FlyyingPiggy2020/HT3505-J9-2E/FreeCAD/HT3505-J9-2E.png

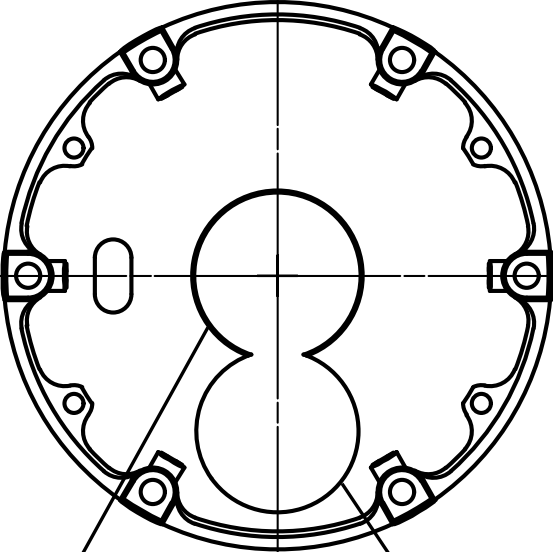
FreeCAD/HT3505-J9-2E.png
