FlyyingPiggy2020/HT3505-J9-2E/KiCad/HT3505-J9-2E-MCU-V1.01/review/latest-driver.png

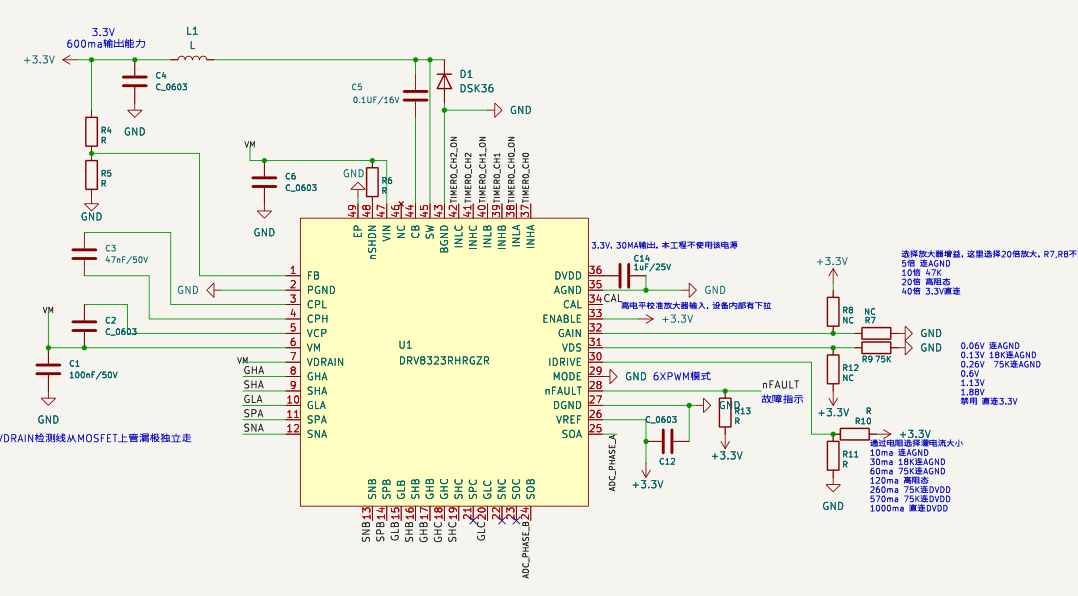
KiCad/HT3505-J9-2E-MCU-V1.01/review/latest-driver.png
