FlyyingPiggy2020/HT3505-J9-2E/KiCad/HT3505-J9-2E-MCU-V1.01/review/mt6701-i2c.png

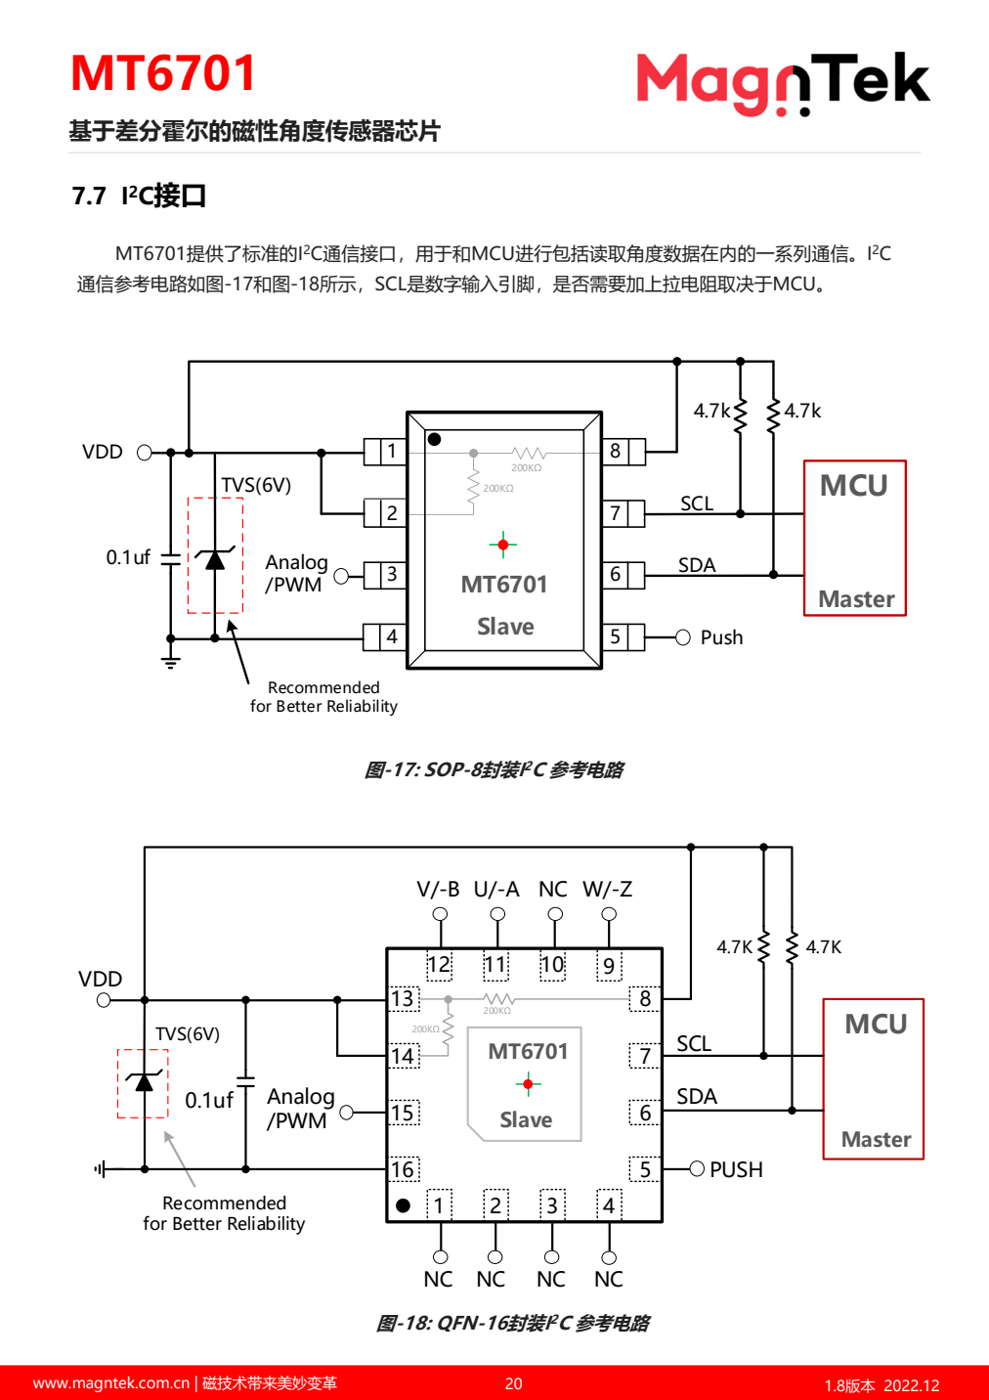
KiCad/HT3505-J9-2E-MCU-V1.01/review/mt6701-i2c.png
