FlyyingPiggy2020/HT3505-J9-2E/FreeCAD/Housing-BodySketch.dxf

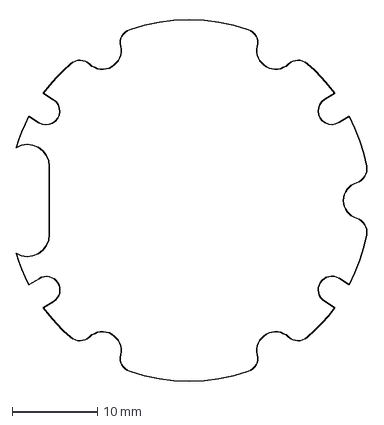
[picture p9: CAD file, 2026-09-28]
FreeCAD/Housing-BodySketch.dxf
41.4 x 43.3 mm
