FlyyingPiggy2020/HT3505-J9-2E/KiCad/HT3505-J9-2E.stl

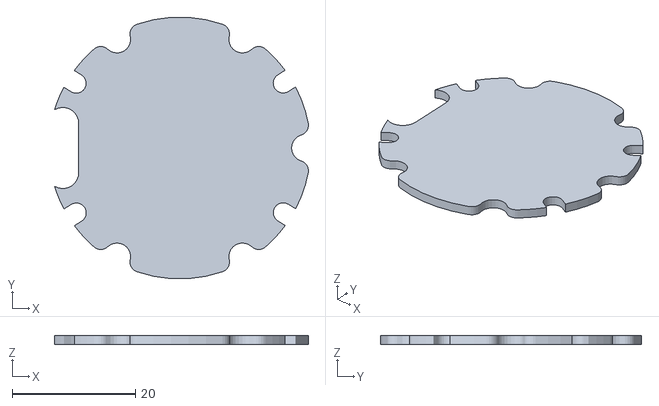
[picture p10: CAD file, 2026-09-28]
KiCad/HT3505-J9-2E.stl
41.2 x 42.4 x 1.51
