FlyyingPiggy2020/HT3505-J9-2E/(list of files, cad)

Other CAD files:
FreeCAD/Housing.FCStd
