FlyyingPiggy2020/HT3505-J9-2E/KiCad/HT3505-J9-2E-MCU-V1.01/review/sep26-schematic.pdf

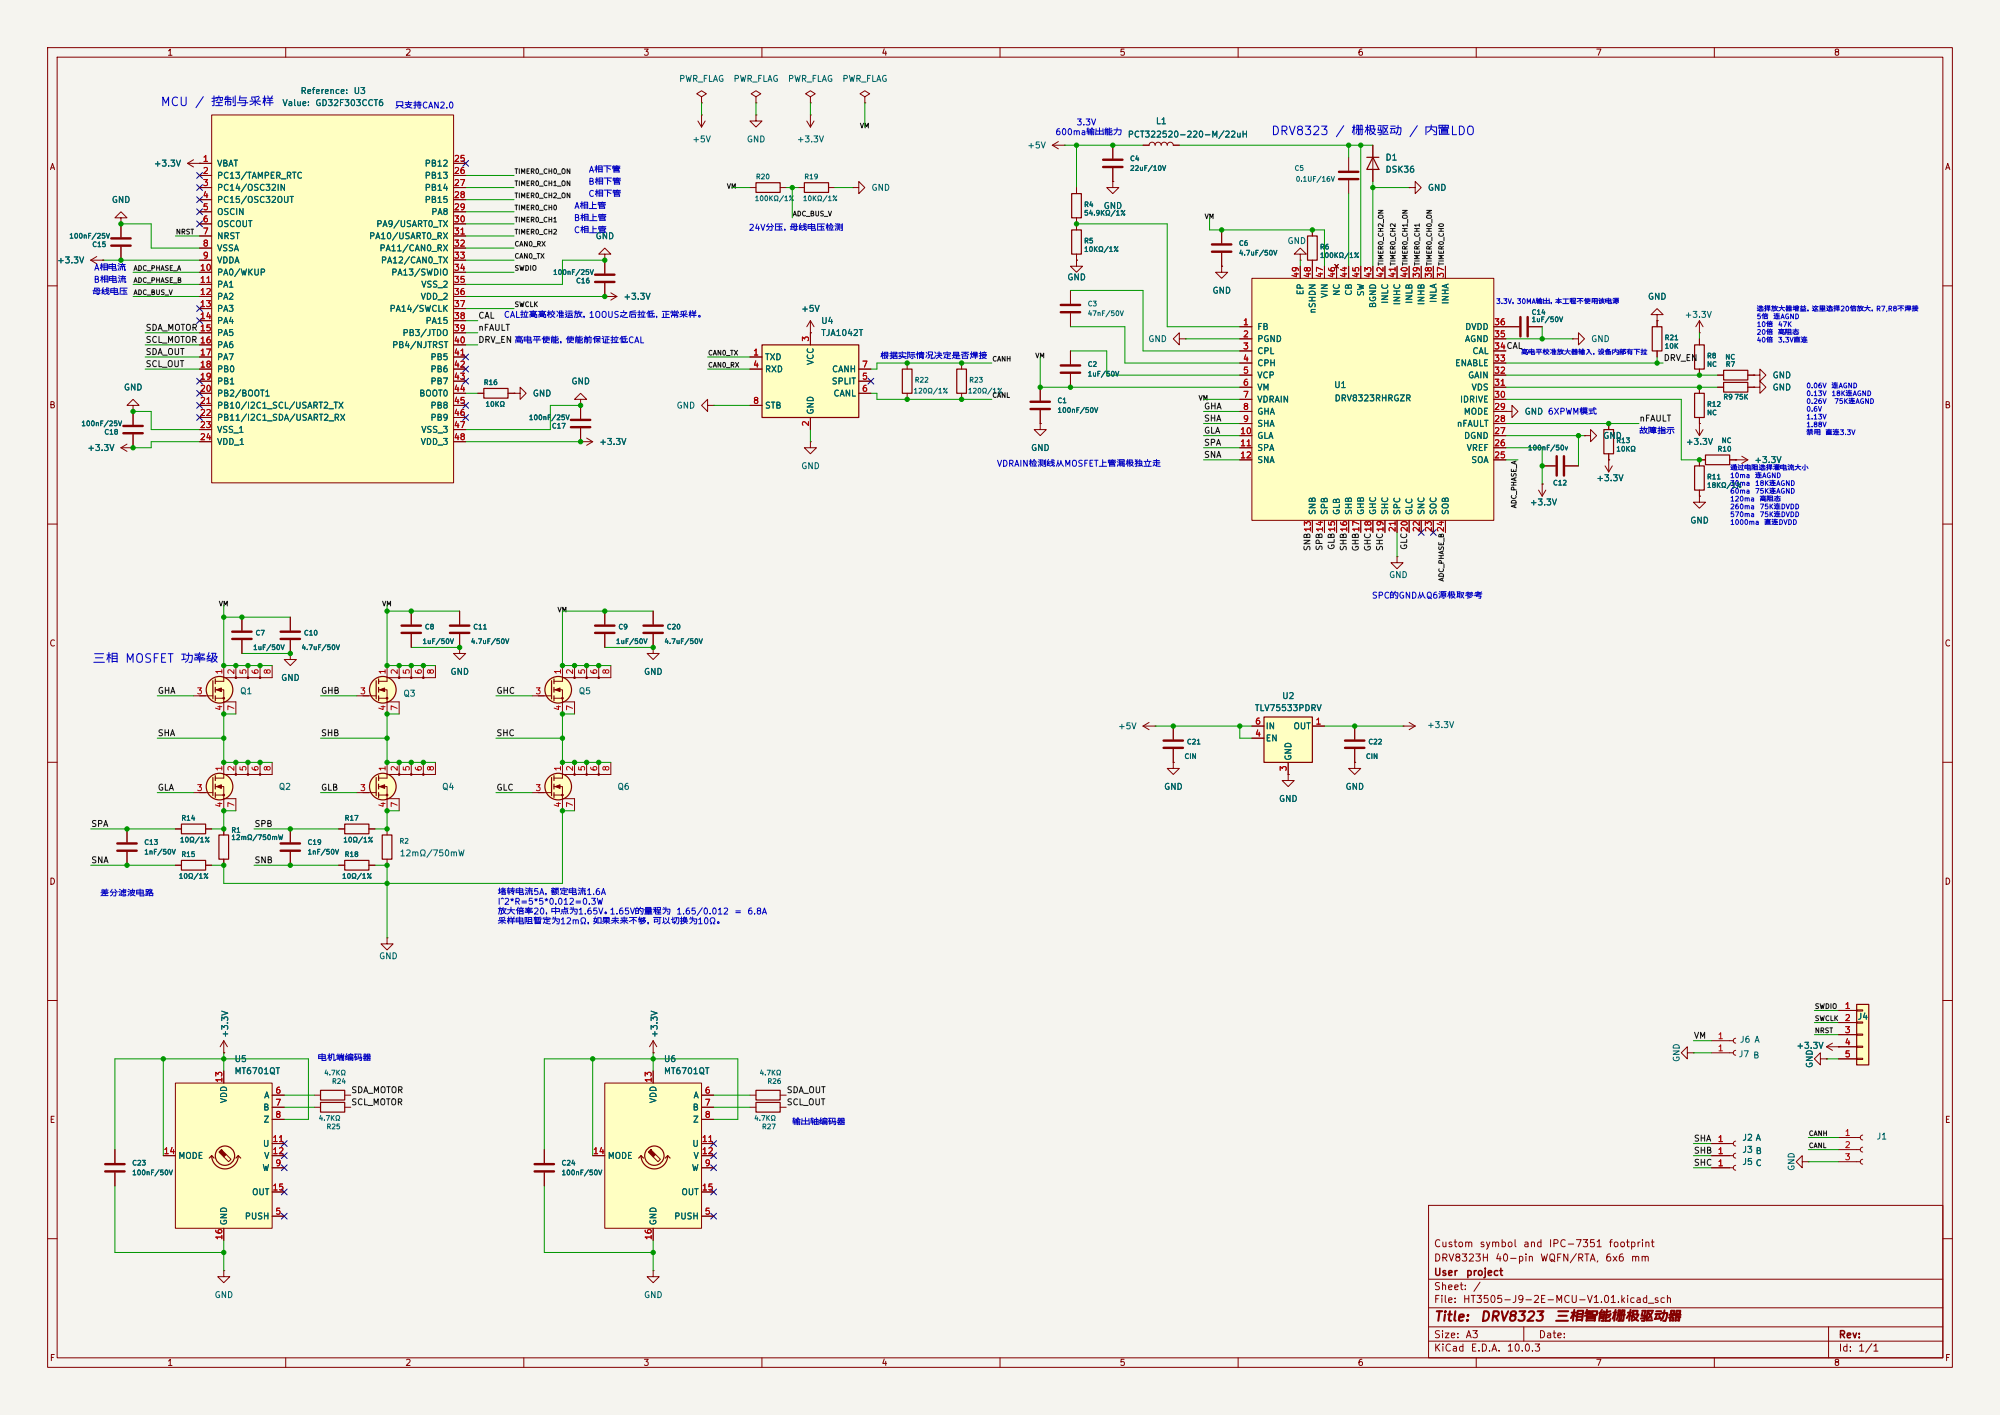
[picture p11: page 1]

0.6V 1.13V 1.88V 禁用 直连3.3V A相电流
B相电流
母线电压
3.3V，30MA输出，本工程不使用该电源 三相 MOSFET 功率级

Custom symbol and IPC-7351 footprint
DRV8323H 40-pin WQFN/RTA, 6x6 mm
User project
Sheet: /
File: HT3505-J9-2E-MCU-V1.01.kicad_sch
Title: DRV8323 三相智能栅极驱动器

Size: A3 | Rev: | F Date:
KiCad E.D.A. 10.0.3 | Id: 1/1
