FlyyingPiggy2020/HT3505-J9-2E/FreeCAD/HT3505-J9-2E电机双编-无驱动盖-安装图-20250916.pdf

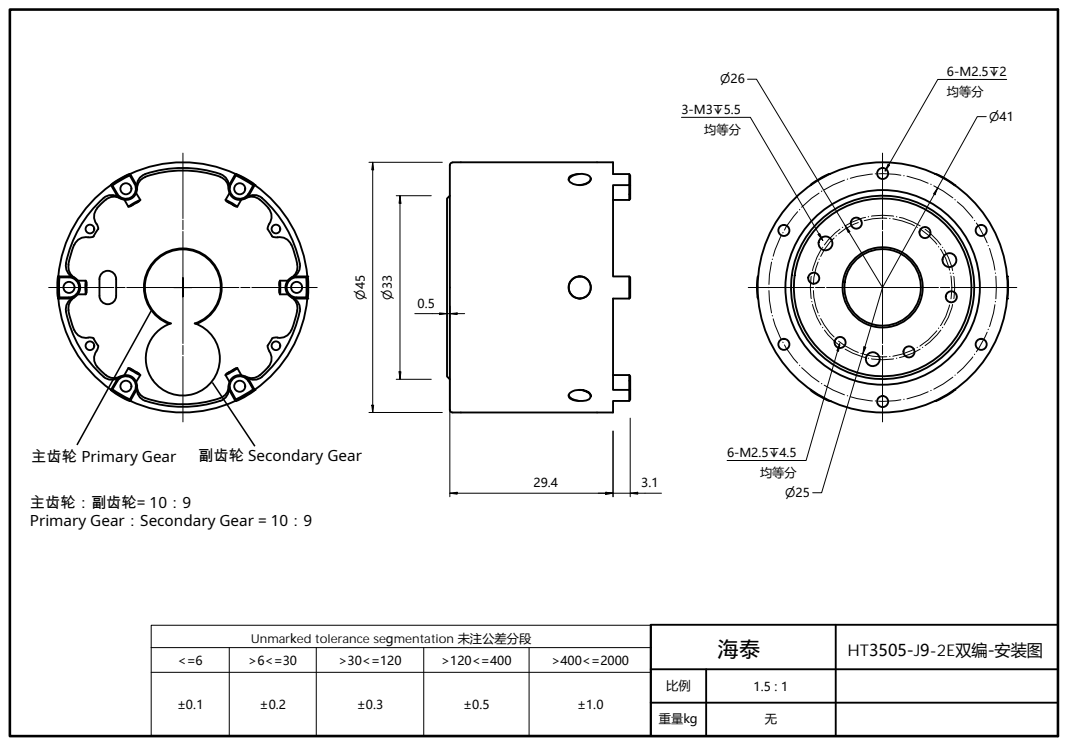
[picture p12: page 1]
主齿轮 Primary Gear; Secondary Gear

主齿轮：副齿轮= 10：9
Primary Gear：Secondary Gear = 10：9

UnmarQed tolerance seMmentation 未注公差分段 | 海泰 | HT3505-J9-2E双编-安装图

重量kg | 无
